Tommycode3/lossless-dac/layout/layout.kicad_pcb

## KiCad design layout/layout.kicad_pcb (2026-10-30)

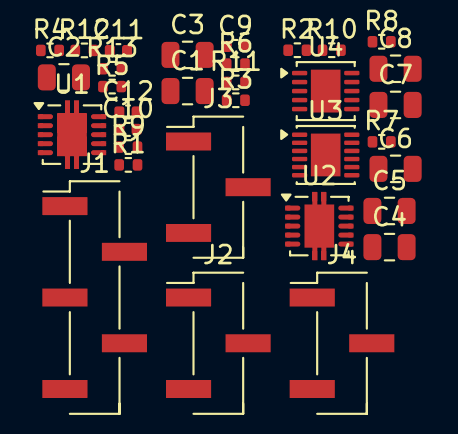
[picture p1: board layout.kicad_pcb from above]

Board: 4 copper layers, 33 parts (0 on the bottom side), 21 nets, no tracks yet.

Parts:
C1, C2: 2.2uF; C_0805_2012Metric
C3, C4, C5, C6: GRM21BZ71E106KE15K; C_0805_2012Metric
C7, C8: GRM21BZ71H475KE15K; C_0805_2012Metric
C9, C10, C11, C12: GCM155R71H104KE02D; C_0402_1005Metric
J1: 2.54mm 5 x 1 SMD Vertical Male; PinHeader_1x05_P2.54mm_Vertical_SMD_Pin1Left
J2, J3, J4: 2.54mm 3 x 1 SMD Vertical Male; PinHeader_1x03_P2.54mm_Vertical_SMD_Pin1Left
R1, R2, R11: ERJ-2RKF1003X; R_0402_1005Metric
R3, R4, R5, R6: ERJ-2RKF1001X; R_0402_1005Metric
R7: ERJ-2RKF7501X; R_0402_1005Metric
R8: ERJ-2RKF3000X; R_0402_1005Metric
R9: ERJ-2RKF9312X; R_0402_1005Metric
R10: ERJ-2RKF6041X; R_0402_1005Metric
R12, R13: ERJ-2RKF4992X; R_0402_1005Metric
U1, U2: OPA1622IDRCR; OPA1622
U3: LT3094EDD#PBF; LT3094
U4: LT3045EDD#PBF; LT3045

Connections:
DAC_L: C1.1, J2.1
DAC_R: C2.1, J2.3
GND: C3.2, C4.2, C5.2, C6.2, C7.2, C8.2, C9.2, C10.2, C11.2, C12.2, J1.5, J2.2, J3.2, J4.3, R1.2, R2.2, R7.2, R8.2, R10.2, R12.2, R13.2, U1.3, U1.5, U2.3, U2.5, U3.9, U4.8, U4.11
ILIM_N: R7.1, U3.6
ILIM_P: R8.1, U4.5
L_INBUF: C1.2, R1.1, U1.1
L_INV: R3.2, R5.2, U1.6
L_NEG: J1.3, R3.1, U1.7
L_POS: J1.1, J4.1, R5.1, U1.9, U1.10
PGFB_P: R9.2, R10.1, U4.6
PG_POS: R11.1, U4.4
R_INBUF: C2.2, R2.1, U2.1
R_INV: R4.2, R6.2, U2.6
R_NEG: J1.4, R4.1, U2.7
R_POS: J1.2, J4.2, R6.1, U2.9, U2.10
SET_N: C7.1, R12.1, U3.8
SET_P: C8.1, R13.1, U4.7
VA_NEG: C5.1, C9.1, C10.1, U1.4, U1.11, U2.4, U2.11, U3.5, U3.10, U3.11, U3.12
VA_POS: C6.1, C11.1, C12.1, R9.1, R11.2, U1.2, U1.8, U2.2, U2.8, U4.9, U4.10
VIN_N: C3.1, J3.3, U3.1, U3.2, U3.3, U3.13
VIN_P: C4.1, J3.1, U4.1, U4.2, U4.3
