Tommycode3/lossless-dac/(commit log)

2026-10-30 Prepare for public release
    - Zener design (LT3045/LT3094 ±5 V rails + 2× OPA1622 balanced stage),
    per-part components, 4-layer KiCad layout (placed, unrouted)
    - README with power tree / signal chain diagrams, rail, gain, noise and
    output-power derivations, design trade-offs and explicit status
    - Add (version ...) header to component symbol libraries so they load in
    KiCad and in pcb 0.4.95
    - Ignore vendored Zener stdlib (.pcb/), generated layout files and
    datasheet conversions (scans/)
    - Add CERN-OHL-S-2.0 license
    [layout.kicad_pcb]
2026-10-30 README: tighten
